Kalo08/Buddy/README.md

BuddyLogo
