Kalo08/Buddy/hardware/buddy_main/notebook/bom.csv

Refs | Value | Footprint | Qty
C1 | 100uF 16V | Capacitor_SMD:CP_Elec_6.3x7.7 | 1
C2,C4,C9,C22,C26 | 10uF 25V | Capacitor_SMD:C_1206_3216Metric | 5
C3,C5,C6,C10,C11,C19,C20,C23,C27,C32,C33,C36 | 100nF | Capacitor_SMD:C_0603_1608Metric | 12
C7,C8,C12,C13,C18 | 22uF 10V | Capacitor_SMD:C_0805_2012Metric | 5
C14-C17,C21,C34,C35,C37 | 1uF | Capacitor_SMD:C_0603_1608Metric | 8
C24,C28 | 10nF 16V | Capacitor_SMD:C_0603_1608Metric | 2
C25,C29 | 2.2uF | Capacitor_SMD:C_0603_1608Metric | 2
C30 | 47uF 16V | Capacitor_SMD:CP_Elec_6.3x7.7 | 1
C31 | 10uF 10V | Capacitor_SMD:C_0805_2012Metric | 1
D1 | SMBJ24CA | Diode_SMD:D_SMB | 1
D2 | SMAJ5.0A | Diode_SMD:D_SMA | 1
D3 | SS34 | Diode_SMD:D_SMA | 1
D4 | PWR green | LED_SMD:LED_0603_1608Metric | 1
D5 | STATUS blue | LED_SMD:LED_0603_1608Metric | 1
F1 | PTC 3A hold | Fuse:Fuse_2920_7451Metric | 1
F2 | PTC 1.1A hold | Fuse:Fuse_1206_3216Metric | 1
J1 | XT30 BATTERY | Connector_AMASS:AMASS_XT30U-M_1x02_P5.0mm_Vertical | 1
J2 | JST-PH BATTERY | Connector_JST:JST_PH_B2B-PH-K_1x02_P2.00mm_Vertical | 1
J3 | USB-C | Connector_USB:USB_C_Receptacle_GCT_USB4105-xx-A_16P_TopMnt_Horizontal | 1
J4 | UART DEBUG | Connector_PinHeader_2.54mm:PinHeader_1x04_P2.54mm_Vertical | 1
J5 | MOTOR 1 | Connector_JST:JST_XH_B2B-XH-A_1x02_P2.50mm_Vertical | 1
J6 | MOTOR 2 | Connector_JST:JST_XH_B2B-XH-A_1x02_P2.50mm_Vertical | 1
J7 | MOTOR 3 | Connector_JST:JST_XH_B2B-XH-A_1x02_P2.50mm_Vertical | 1
J8 | SPEAKER 4-8R | Connector_JST:JST_PH_B2B-PH-K_1x02_P2.00mm_Vertical | 1
J9 | I2S MIC (INMP441) | Connector_PinSocket_2.54mm:PinSocket_1x06_P2.54mm_Vertical | 1
J10 | CAMERA OV2640 24P | Connector_FFC-FPC:Hirose_FH12-24S-0.5SH_1x24-1MP_P0.50mm_Horizontal | 1
L1 | 4.7uH | Inductor_SMD:L_Bourns_SRN6045TA | 1
L2 | 6.8uH | Inductor_SMD:L_Bourns_SRN6045TA | 1
Q1 | Si4214DDY | Package_SO:SOIC-8_3.9x4.9mm_P1.27mm | 1
R1,R18 | 1M | Resistor_SMD:R_0603_1608Metric | 2
R2,R6 | 33k | Resistor_SMD:R_0603_1608Metric | 2
R3 | 56k | Resistor_SMD:R_0603_1608Metric | 1
R4,R5,R13 | 100k | Resistor_SMD:R_0603_1608Metric | 3
R7,R12 | 1k | Resistor_SMD:R_0603_1608Metric | 2
R8,R9,R14,R19,R20 | 10k | Resistor_SMD:R_0603_1608Metric | 5
R10,R11 | 5.1k | Resistor_SMD:R_0603_1608Metric | 2
R15-R17 | 0.1R 1206 | Resistor_SMD:R_1206_3216Metric | 3
R21,R22 | 4.7k | Resistor_SMD:R_0603_1608Metric | 2
SW1 | POWER | Button_Switch_SMD:SW_SPDT_PCM12 | 1
SW2 | RESET | Button_Switch_SMD:SW_SPST_PTS810 | 1
SW3 | BOOT | Button_Switch_SMD:SW_SPST_PTS810 | 1
U1 | LTC4365TS8 | Package_TO_SOT_SMD:TSOT-23-8 | 1
U2 | AP63203WU | Package_TO_SOT_SMD:TSOT-23-6 | 1
U3 | AP63205WU | Package_TO_SOT_SMD:TSOT-23-6 | 1
U4 | XC6206P282MR | Package_TO_SOT_SMD:SOT-23-3 | 1
U5 | XC6206P122MR | Package_TO_SOT_SMD:SOT-23-3 | 1
U6 | ESP32-S3-WROOM-1-N16R8 | RF_Module:ESP32-S3-WROOM-1 | 1
U7 | USBLC6-2SC6 | Package_TO_SOT_SMD:SOT-23-6 | 1
U8,U9 | DRV8833PWP | Package_SO:HTSSOP-16-1EP_4.4x5mm_P0.65mm_EP3.4x5mm_Mask2.46x2.31mm_ThermalVias | 2
U10 | MAX98357A | Package_DFN_QFN:TQFN-16-1EP_3x3mm_P0.5mm_EP1.23x1.23mm | 1
