Kalo08/Buddy/hardware/buddy_main/3d/Fuse_2920_7451Metric.step

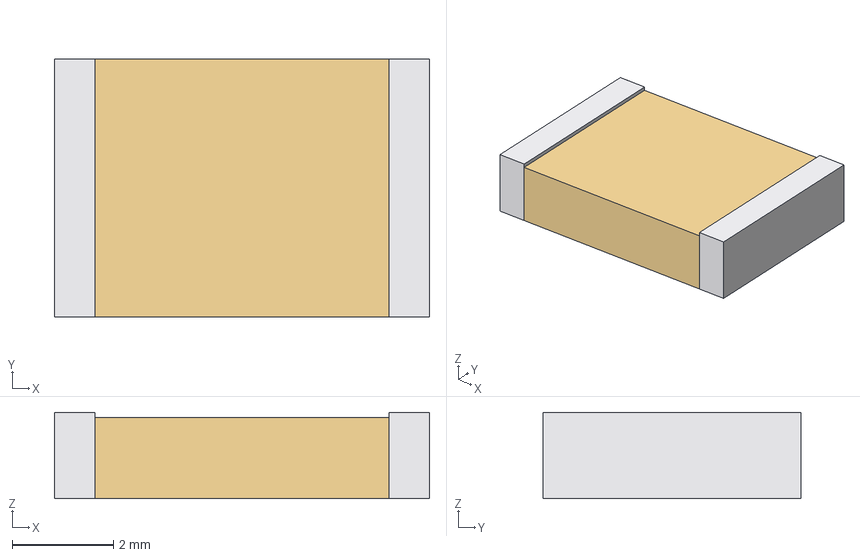
[picture p10: CAD file, 2026-10-29]
hardware/buddy_main/3d/Fuse_2920_7451Metric.step
7.40 x 5.10 x 1.70 mm
