Kalo08/Buddy/hardware/buddy_main/3d/AMASS_XT30U-M_1x02_P5.0mm_Vertical.step

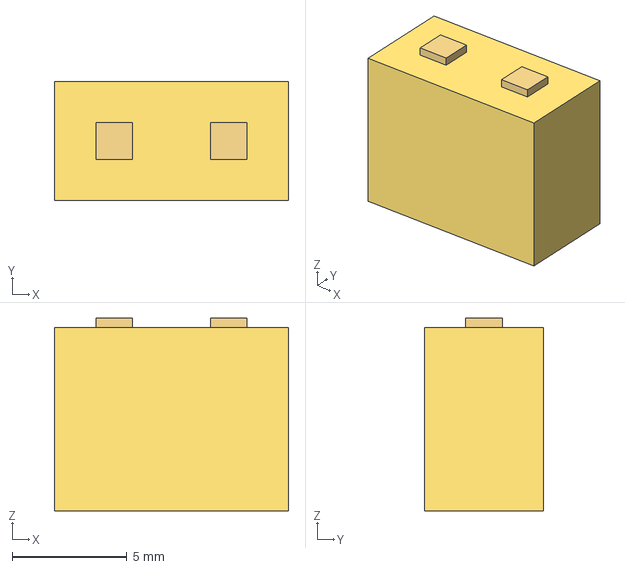
[picture p11: CAD file, 2026-10-29]
hardware/buddy_main/3d/AMASS_XT30U-M_1x02_P5.0mm_Vertical.step
10.2 x 5.20 x 8.40 mm
