Kalo08/Buddy/(list of files, drawings)

Other design files:
hardware/buddy_main/route/buddy_main.dsn
