Kalo08/Buddy/hardware/buddy_main/buddy_main.kicad_pcb

## KiCad design hardware/buddy_main/buddy_main.kicad_pcb (2026-10-31)

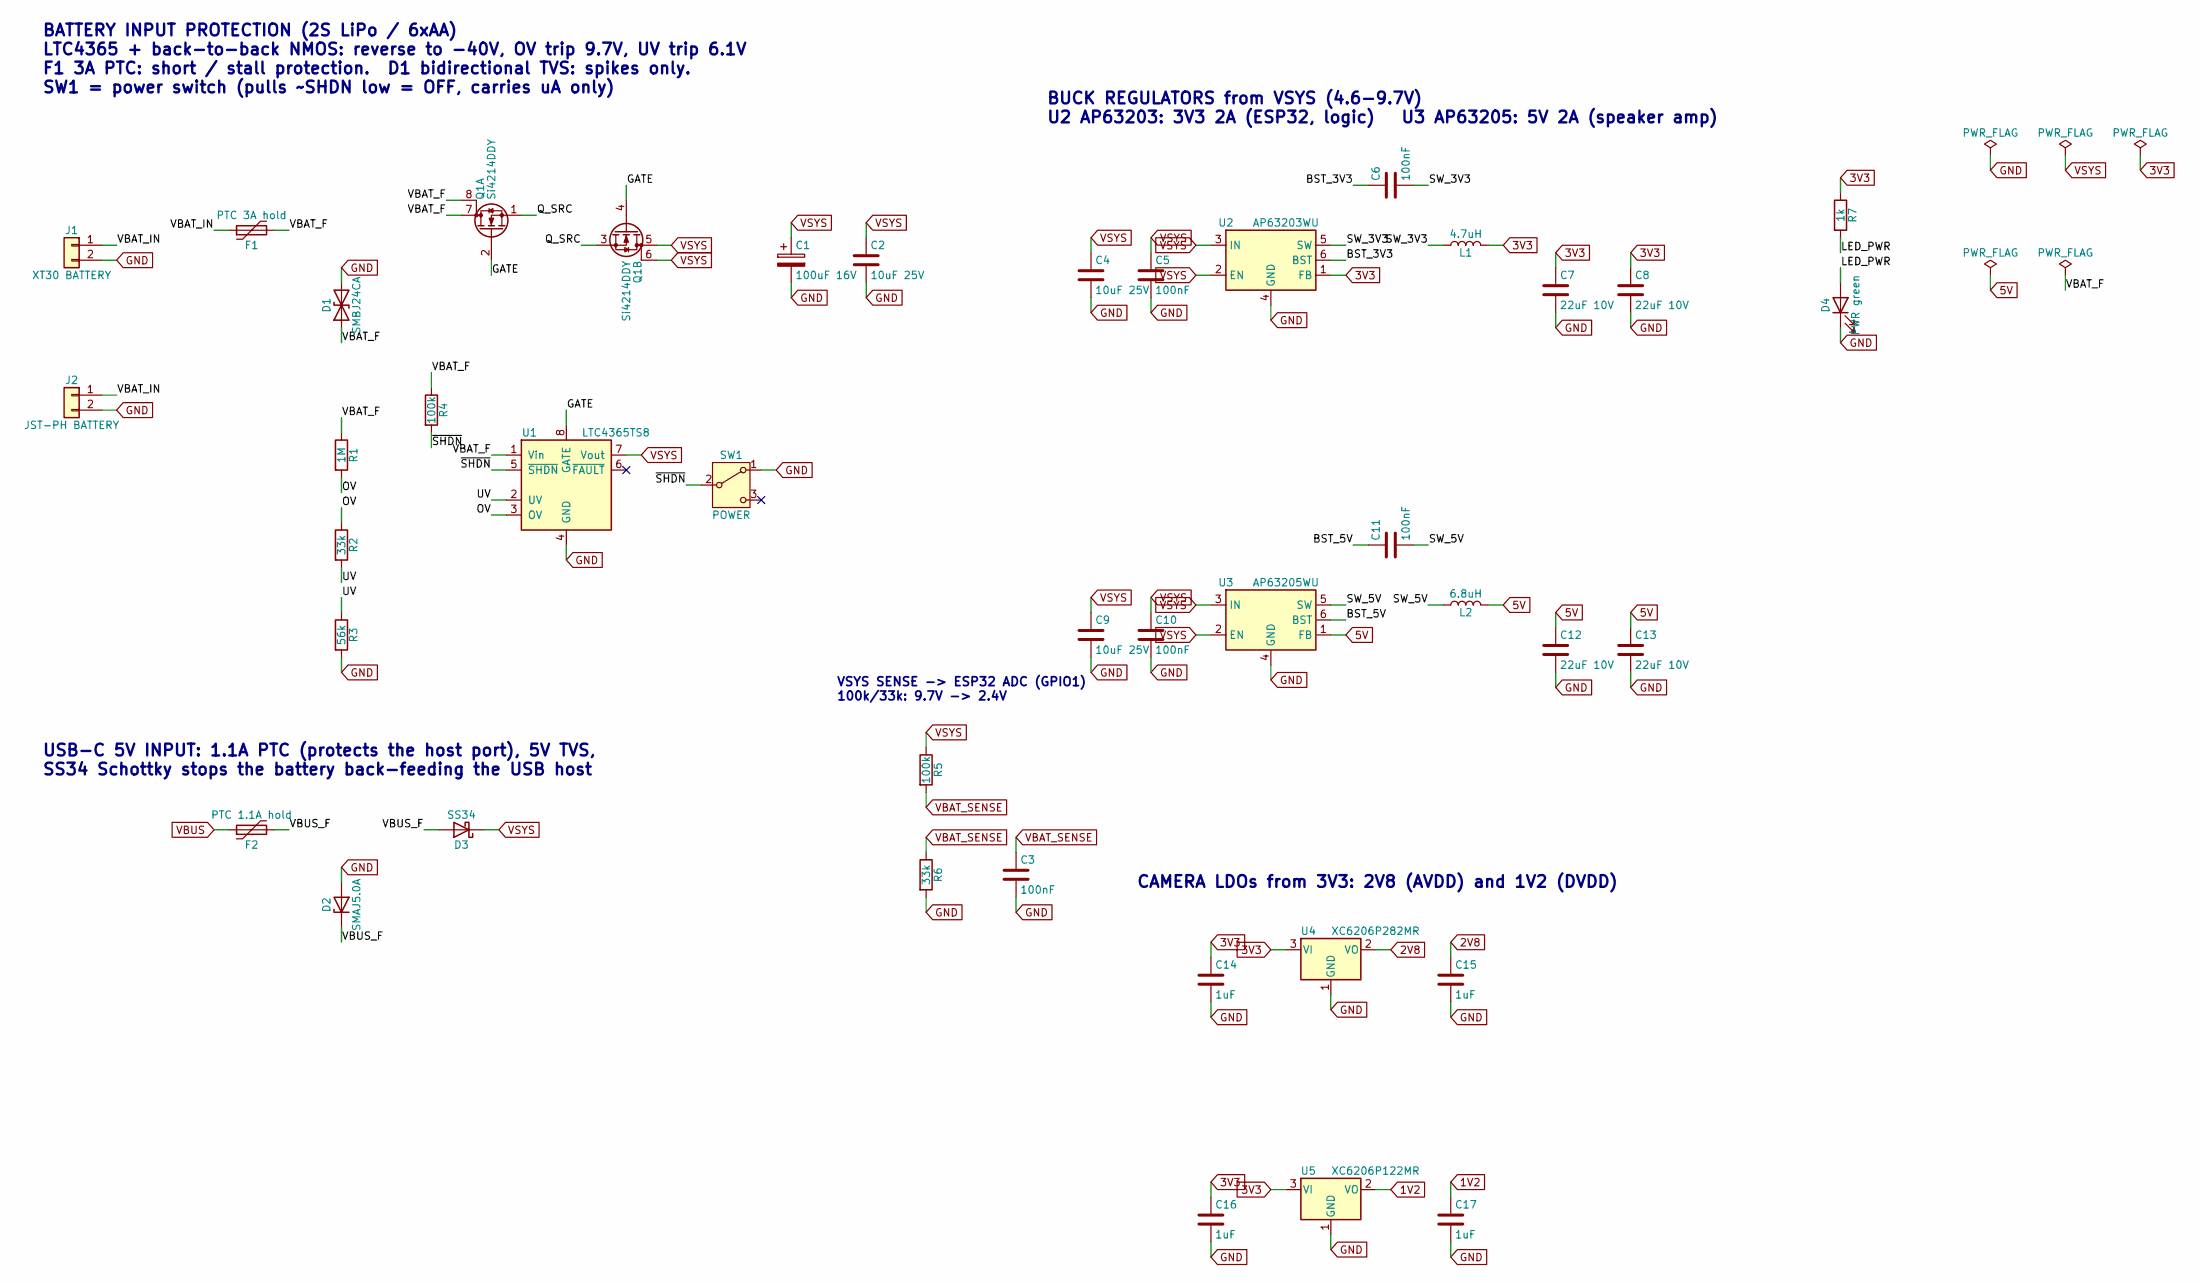
[picture p12: schematic power.kicad_sch]

Parts:
C1: 100uF 16V; CP_Elec_6.3x7.7
C2, C4, C9: 10uF 25V; C_1206_3216Metric
C3, C5, C6, C10, C11: 100nF; C_0603_1608Metric
C7, C8, C12, C13: 22uF 10V; C_0805_2012Metric
C14, C15, C16, C17: 1uF; C_0603_1608Metric
D1: SMBJ24CA; D_SMB
D2: SMAJ5.0A; D_SMA
D3: SS34; D_SMA
D4: PWR green; LED_0603_1608Metric
F1: PTC 3A hold; Fuse_2920_7451Metric
F2: PTC 1.1A hold; Fuse_1206_3216Metric
J1: XT30 BATTERY; AMASS_XT30U-M_1x02_P5.0mm_Vertical
J2: JST-PH BATTERY; JST_PH_B2B-PH-K_1x02_P2.00mm_Vertical
L1: 4.7uH; L_Bourns_SRN6045TA
L2: 6.8uH; L_Bourns_SRN6045TA
Q1: Si4214DDY; SOIC-8_3.9x4.9mm_P1.27mm
R1: 1M; R_0603_1608Metric
R2, R6: 33k; R_0603_1608Metric
R3: 56k; R_0603_1608Metric
R4, R5: 100k; R_0603_1608Metric
R7: 1k; R_0603_1608Metric
SW1: POWER; SW_SPDT_PCM12
U1: LTC4365TS8; TSOT-23-8
U2: AP63203WU; TSOT-23-6
U3: AP63205WU; TSOT-23-6
U4: XC6206P282MR; SOT-23-3
U5: XC6206P122MR; SOT-23-3

Connections:
1V2: C17.1, U5.2 (VO); also elsewhere on the board
2V8: C15.1, U4.2 (VO); also elsewhere on the board
3V3: C7.1, C8.1, C14.1, C16.1, L1.2, R7.1, U2.1 (FB), U4.3 (VI), U5.3 (VI); also elsewhere on the board
5V: C12.1, C13.1, L2.2, U3.1 (FB); also elsewhere on the board
/Power and Protection/BST_3V3: C6.1, U2.6 (BST)
/Power and Protection/BST_5V: C11.1, U3.6 (BST)
/Power and Protection/GATE: Q1.2 (G), Q1.4 (G), U1.8 (GATE)
/Power and Protection/LED_PWR: D4.2 (A), R7.2
/Power and Protection/OV: R1.2, R2.1, U1.3 (OV)
/Power and Protection/Q_SRC: Q1.1 (S), Q1.3 (S)
/Power and Protection/SW_3V3: C6.2, L1.1, U2.5 (SW)
/Power and Protection/SW_5V: C11.2, L2.1, U3.5 (SW)
/Power and Protection/UV: R2.2, R3.1, U1.2 (UV)
/Power and Protection/VBAT_F: D1.1 (A1), F1.2, Q1.7 (D), Q1.8 (D), R1.1, R4.1, U1.1 (Vin)
/Power and Protection/VBAT_IN: F1.1, J1.1, J2.1
/Power and Protection/VBUS_F: D2.1 (K), D3.2 (A), F2.2
/Power and Protection/~SHDN: R4.2, SW1.2 (B), U1.5 (~SHDN)
GND: C1.2, C2.2, C3.2, C4.2, C5.2, C7.2, C8.2, C9.2, C10.2, C12.2, C13.2, C14.2, C15.2, C16.2, C17.2, D1.2 (A2), D2.2 (A), D4.1 (K), J1.2, J2.2, R3.2, R6.2, SW1.1 (A), U1.4 (GND), U2.4 (GND), U3.4 (GND), U4.1 (GND), U5.1 (GND); also elsewhere on the board
VBAT_SENSE: C3.1, R5.2, R6.1; also elsewhere on the board
VBUS: F2.1; also elsewhere on the board
VSYS: C1.1, C2.1, C4.1, C5.1, C9.1, C10.1, D3.1 (K), Q1.5 (D), Q1.6 (D), R5.1, U1.7 (Vout), U2.2 (EN), U2.3 (IN), U3.2 (EN), U3.3 (IN); also elsewhere on the board

Notes on the sheet:
BATTERY INPUT PROTECTION (2S LiPo / 6xAA) LTC4365 + back-to-back NMOS: reverse to -40V, OV trip 9.7V, UV trip 6.1V F1 3A PTC: short / stall protection. D1 bidirectional TVS: spikes only. SW1 = power switch (pulls ~SHDN low = OFF, carries uA only)
USB-C 5V INPUT: 1.1A PTC (protects the host port), 5V TVS, SS34 Schottky stops the battery back-feeding the USB host
BUCK REGULATORS from VSYS (4.6-9.7V) U2 AP63203: 3V3 2A (ESP32, logic) U3 AP63205: 5V 2A (speaker amp)
CAMERA LDOs from 3V3: 2V8 (AVDD) and 1V2 (DVDD)
VSYS SENSE -> ESP32 ADC (GPIO1) 100k/33k: 9.7V -> 2.4V

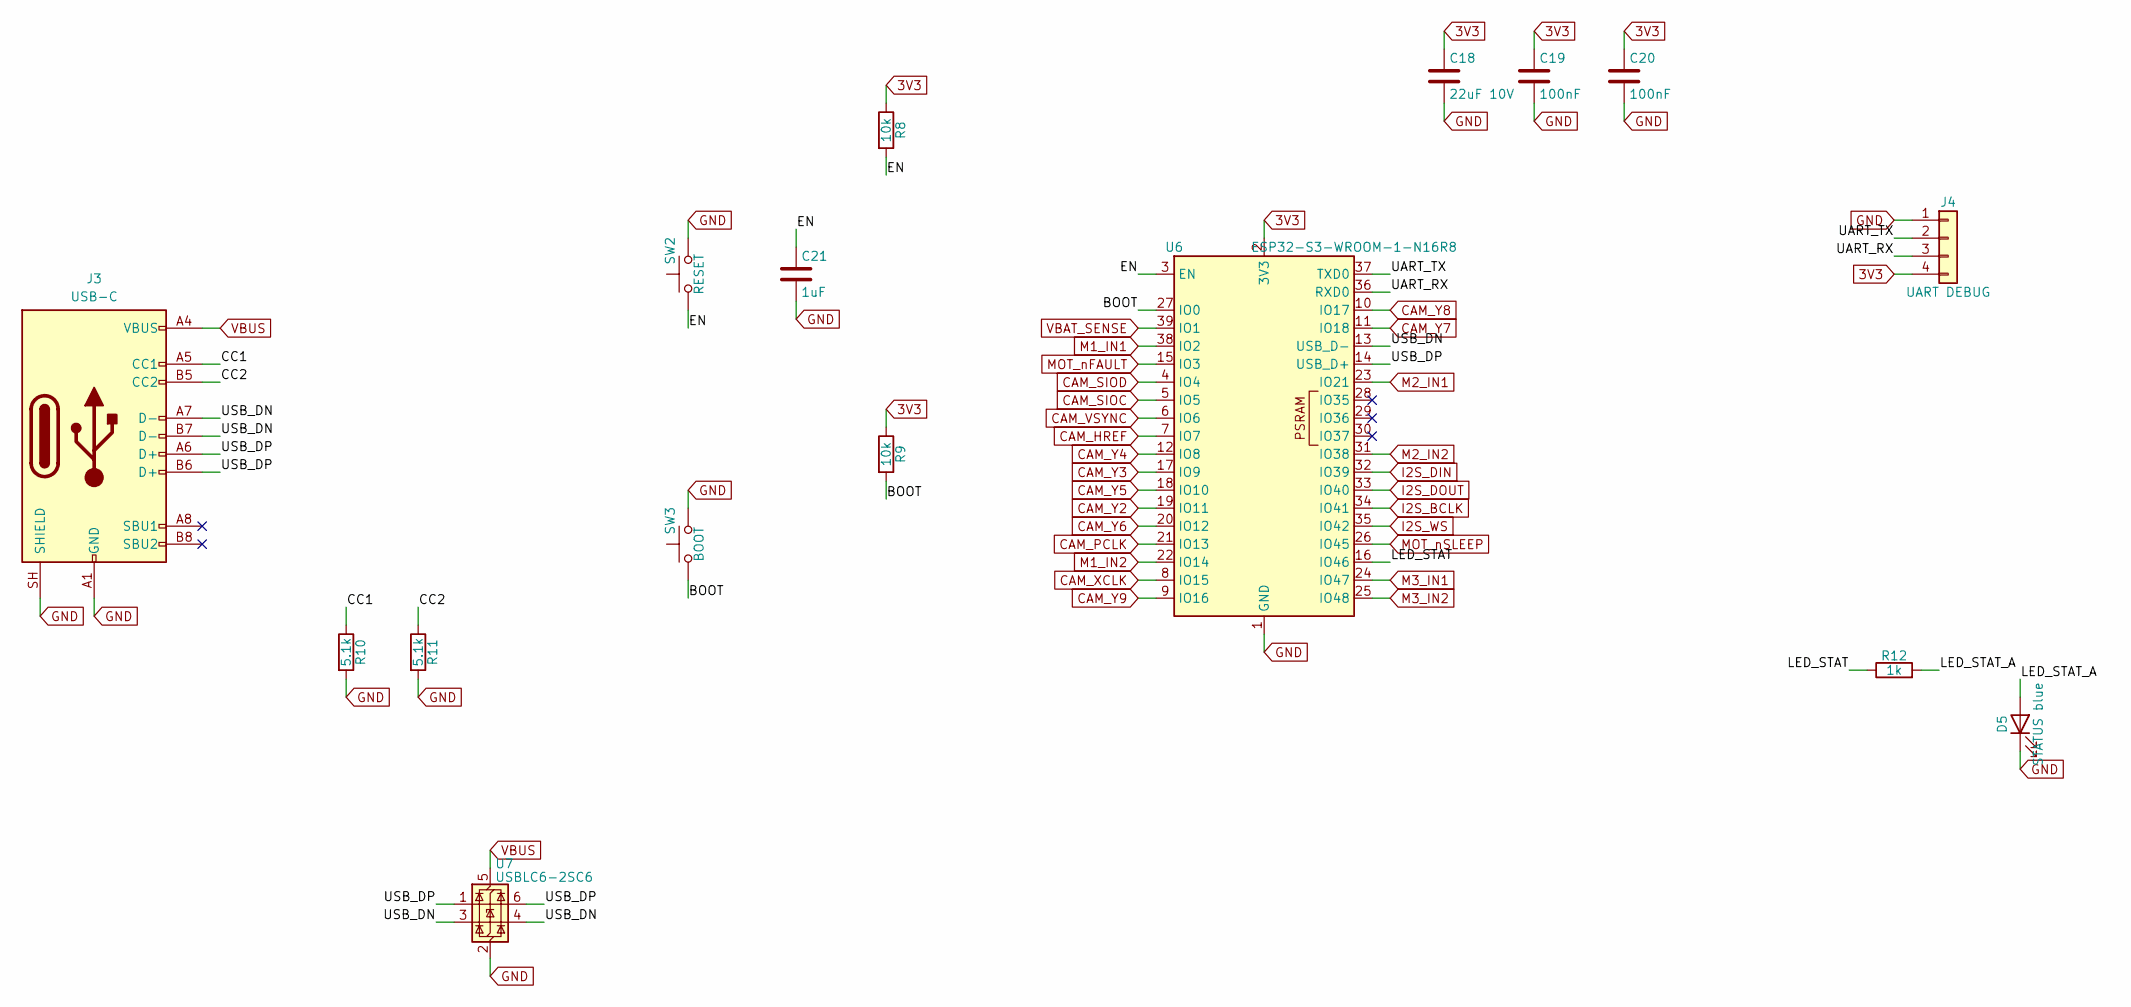
[picture p13: schematic mcu.kicad_sch]

Parts:
C18: 22uF 10V; C_0805_2012Metric
C19, C20: 100nF; C_0603_1608Metric
C21: 1uF; C_0603_1608Metric
D5: STATUS blue; LED_0603_1608Metric
J3: USB-C; USB_C_Receptacle_GCT_USB4105-xx-A_16P_TopMnt_Horizontal
J4: UART DEBUG; PinHeader_1x04_P2.54mm_Vertical
R8, R9: 10k; R_0603_1608Metric
R10, R11: 5.1k; R_0603_1608Metric
R12: 1k; R_0603_1608Metric
SW2: RESET; SW_SPST_PTS810
SW3: BOOT; SW_SPST_PTS810
U6: ESP32-S3-WROOM-1-N16R8; ESP32-S3-WROOM-1
U7: USBLC6-2SC6; SOT-23-6

Connections:
3V3: C18.1, C19.1, C20.1, J4.4, R8.1, R9.1, U6.2 (3V3); also elsewhere on the board
/MCU and USB/BOOT: R9.2, SW3.1, U6.27 (IO0)
/MCU and USB/CC1: J3.A5 (CC1), R10.1
/MCU and USB/CC2: J3.B5 (CC2), R11.1
/MCU and USB/EN: C21.1, R8.2, SW2.1, U6.3 (EN)
/MCU and USB/LED_STAT: R12.1, U6.16 (IO46)
/MCU and USB/LED_STAT_A: D5.2 (A), R12.2
/MCU and USB/UART_RX: J4.3, U6.36 (RXD0)
/MCU and USB/UART_TX: J4.2, U6.37 (TXD0)
/MCU and USB/USB_DN: J3.A7 (D-), J3.B7 (D-), U6.13 (USB_D-), U7.3 (I/O2), U7.4 (I/O2)
/MCU and USB/USB_DP: J3.A6 (D+), J3.B6 (D+), U6.14 (USB_D+), U7.1 (I/O1), U7.6 (I/O1)
CAM_HREF: U6.7 (IO7); also elsewhere on the board
CAM_PCLK: U6.21 (IO13); also elsewhere on the board
CAM_SIOC: U6.5 (IO5); also elsewhere on the board
CAM_SIOD: U6.4 (IO4); also elsewhere on the board
CAM_VSYNC: U6.6 (IO6); also elsewhere on the board
CAM_XCLK: U6.8 (IO15); also elsewhere on the board
CAM_Y2: U6.19 (IO11); also elsewhere on the board
CAM_Y3: U6.17 (IO9); also elsewhere on the board
CAM_Y4: U6.12 (IO8); also elsewhere on the board
CAM_Y5: U6.18 (IO10); also elsewhere on the board
CAM_Y6: U6.20 (IO12); also elsewhere on the board
CAM_Y7: U6.11 (IO18); also elsewhere on the board
CAM_Y8: U6.10 (IO17); also elsewhere on the board
CAM_Y9: U6.9 (IO16); also elsewhere on the board
GND: C18.2, C19.2, C20.2, C21.2, D5.1 (K), J3.A1 (GND), J3.A12 (GND), J3.B1 (GND), J3.B12 (GND), J3.SH (SHIELD), J4.1, R10.2, R11.2, SW2.2, SW3.2, U6.1 (GND), U6.40 (GND), U6.41 (GND), U7.2 (GND); also elsewhere on the board
I2S_BCLK: U6.34 (IO41); also elsewhere on the board
I2S_DIN: U6.32 (IO39); also elsewhere on the board
I2S_DOUT: U6.33 (IO40); also elsewhere on the board
I2S_WS: U6.35 (IO42); also elsewhere on the board
M1_IN1: U6.38 (IO2); also elsewhere on the board
M1_IN2: U6.22 (IO14); also elsewhere on the board
M2_IN1: U6.23 (IO21); also elsewhere on the board
M2_IN2: U6.31 (IO38); also elsewhere on the board
M3_IN1: U6.24 (IO47); also elsewhere on the board
M3_IN2: U6.25 (IO48); also elsewhere on the board
MOT_nFAULT: U6.15 (IO3); also elsewhere on the board
MOT_nSLEEP: U6.26 (IO45); also elsewhere on the board
VBAT_SENSE: U6.39 (IO1); also elsewhere on the board
VBUS: J3.A4 (VBUS), J3.A9 (VBUS), J3.B4 (VBUS), J3.B9 (VBUS), U7.5 (VBUS); also elsewhere on the board

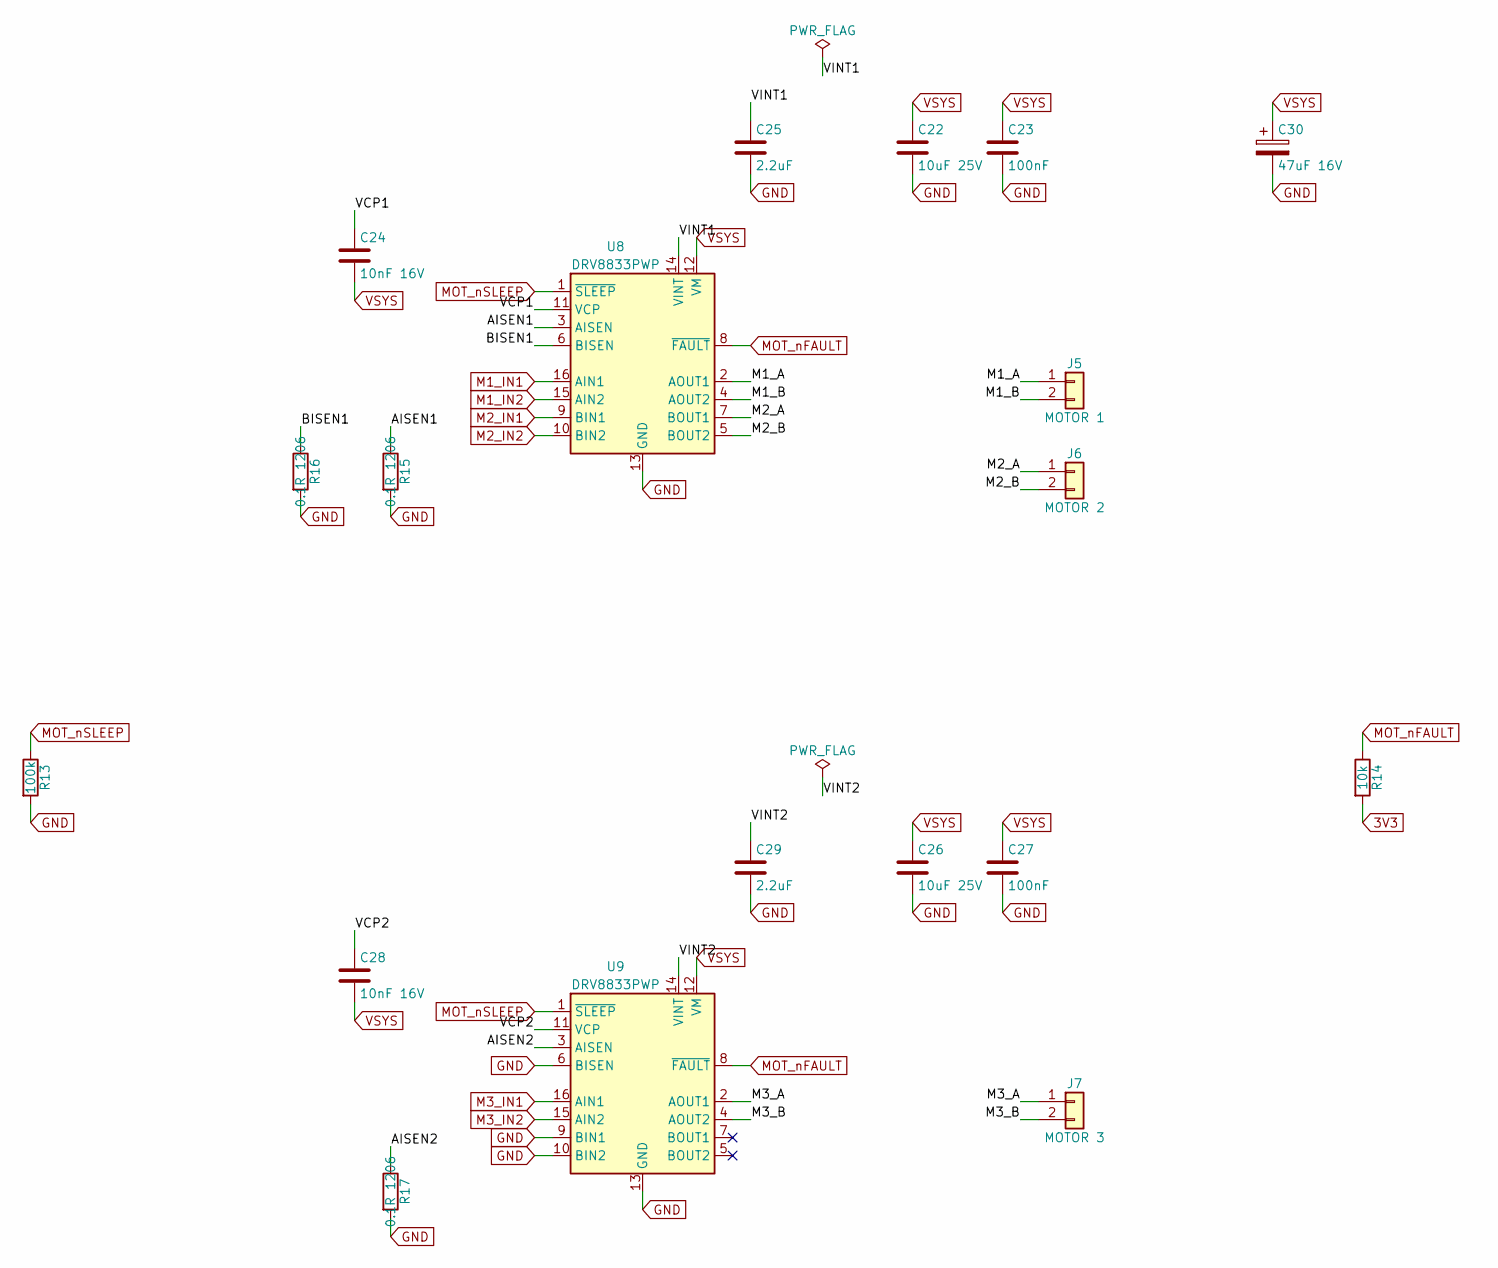
[picture p14: schematic motors.kicad_sch]

Parts:
C22, C26: 10uF 25V; C_1206_3216Metric
C23, C27: 100nF; C_0603_1608Metric
C24, C28: 10nF 16V; C_0603_1608Metric
C25, C29: 2.2uF; C_0603_1608Metric
C30: 47uF 16V; CP_Elec_6.3x7.7
J5: MOTOR 1; JST_XH_B2B-XH-A_1x02_P2.50mm_Vertical
J6: MOTOR 2; JST_XH_B2B-XH-A_1x02_P2.50mm_Vertical
J7: MOTOR 3; JST_XH_B2B-XH-A_1x02_P2.50mm_Vertical
R13: 100k; R_0603_1608Metric
R14: 10k; R_0603_1608Metric
R15, R16, R17: 0.1R 1206; R_1206_3216Metric
U8, U9: DRV8833PWP; HTSSOP-16-1EP_4.4x5mm_P0.65mm_EP3.4x5mm_Mask2.46x2.31mm_The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

Connections:
3V3: R14.2; also elsewhere on the board
/Motor Drivers/AISEN1: R15.1, U8.3 (AISEN)
/Motor Drivers/AISEN2: R17.1, U9.3 (AISEN)
/Motor Drivers/BISEN1: R16.1, U8.6 (BISEN)
/Motor Drivers/M1_A: J5.1, U8.2 (AOUT1)
/Motor Drivers/M1_B: J5.2, U8.4 (AOUT2)
/Motor Drivers/M2_A: J6.1, U8.7 (BOUT1)
/Motor Drivers/M2_B: J6.2, U8.5 (BOUT2)
/Motor Drivers/M3_A: J7.1, U9.2 (AOUT1)
/Motor Drivers/M3_B: J7.2, U9.4 (AOUT2)
/Motor Drivers/VCP1: C24.1, U8.11 (VCP)
/Motor Drivers/VCP2: C28.1, U9.11 (VCP)
/Motor Drivers/VINT1: C25.1, U8.14 (VINT)
/Motor Drivers/VINT2: C29.1, U9.14 (VINT)
GND: C22.2, C23.2, C25.2, C26.2, C27.2, C29.2, C30.2, R13.2, R15.2, R16.2, R17.2, U8.13 (GND), U8.17 (GND), U9.6 (BISEN), U9.9 (BIN1), U9.10 (BIN2), U9.13 (GND), U9.17 (GND); also elsewhere on the board
M1_IN1: U8.16 (AIN1); also elsewhere on the board
M1_IN2: U8.15 (AIN2); also elsewhere on the board
M2_IN1: U8.9 (BIN1); also elsewhere on the board
M2_IN2: U8.10 (BIN2); also elsewhere on the board
M3_IN1: U9.16 (AIN1); also elsewhere on the board
M3_IN2: U9.15 (AIN2); also elsewhere on the board
MOT_nFAULT: R14.1, U8.8 (~FAULT), U9.8 (~FAULT); also elsewhere on the board
MOT_nSLEEP: R13.1, U8.1 (~SLEEP), U9.1 (~SLEEP); also elsewhere on the board
VSYS: C22.1, C23.1, C24.2, C26.1, C27.1, C28.2, C30.1, U8.12 (VM), U9.12 (VM); also elsewhere on the board

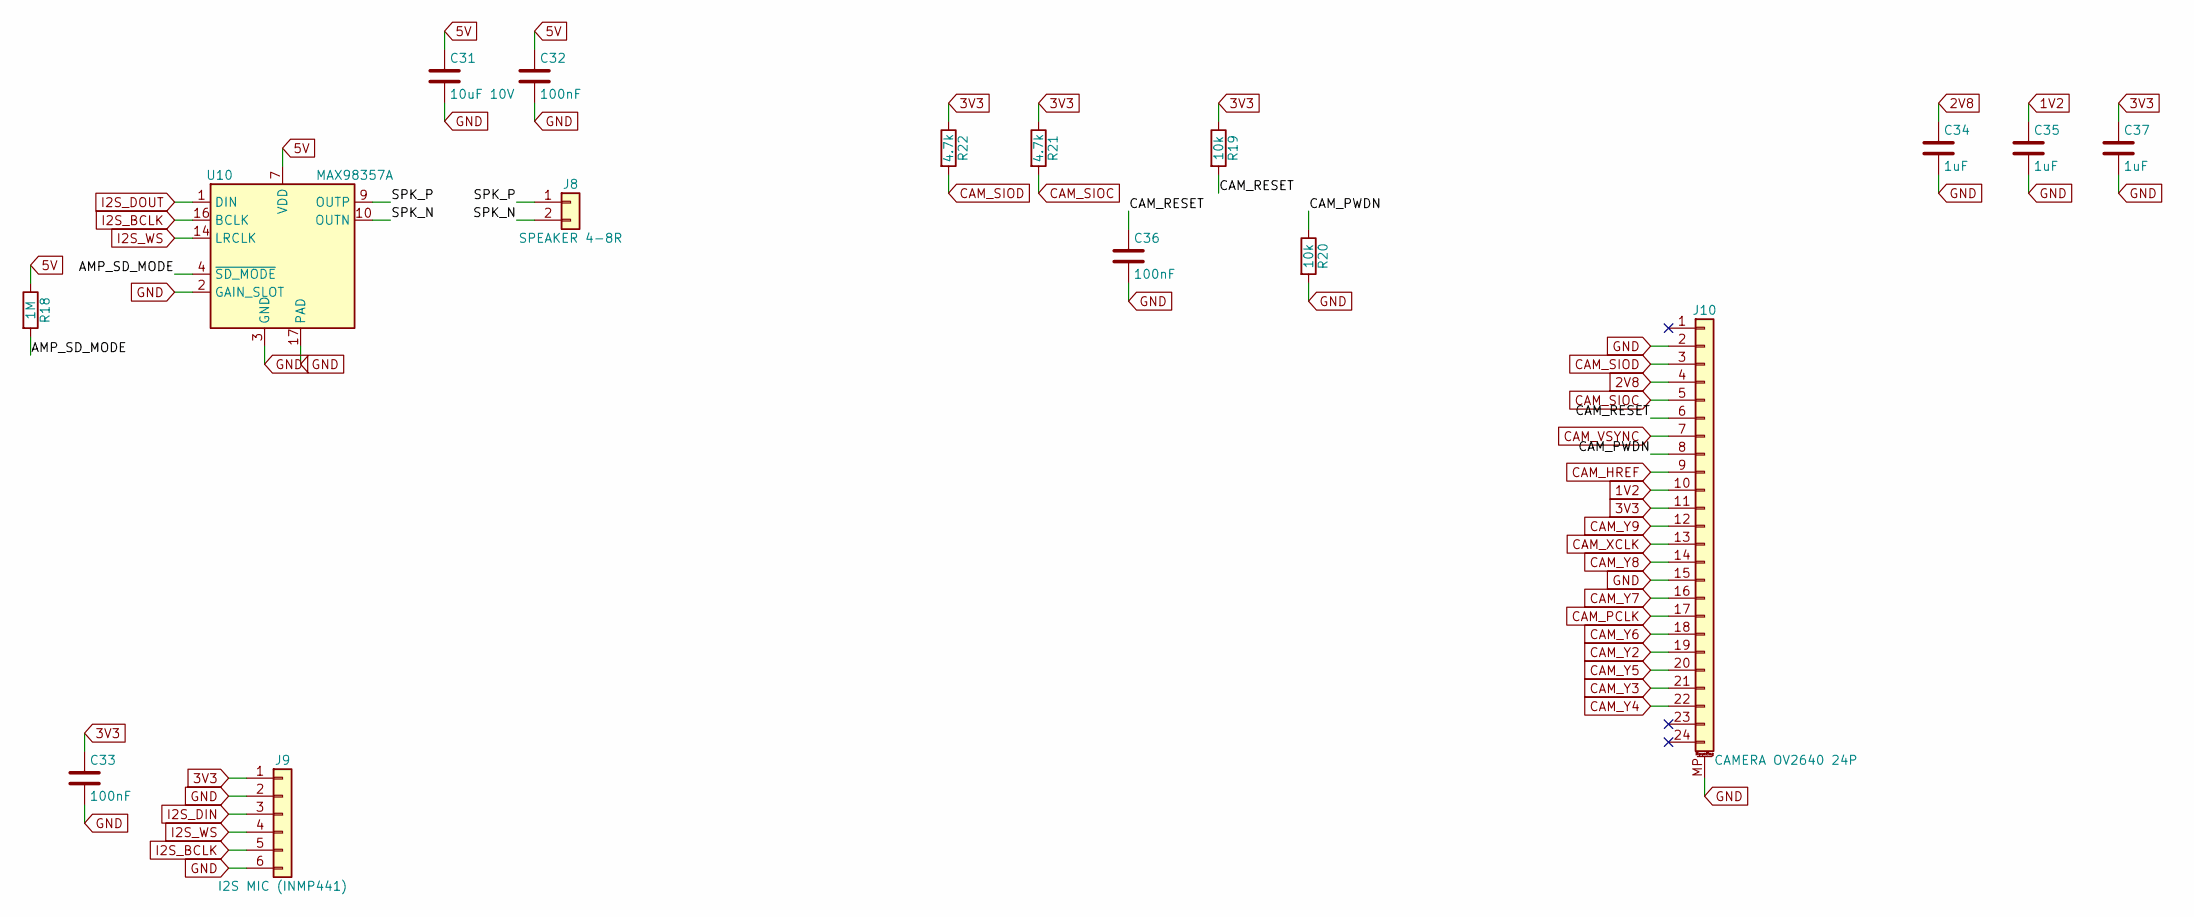
[picture p15: schematic audio_camera.kicad_sch]

Parts:
C31: 10uF 10V; C_0805_2012Metric
C32, C33, C36: 100nF; C_0603_1608Metric
C34, C35, C37: 1uF; C_0603_1608Metric
J8: SPEAKER 4-8R; JST_PH_B2B-PH-K_1x02_P2.00mm_Vertical
J9: I2S MIC (INMP441); PinSocket_1x06_P2.54mm_Vertical
J10: CAMERA OV2640 24P; Hirose_FH12-24S-0.5SH_1x24-1MP_P0.50mm_Horizontal
R18: 1M; R_0603_1608Metric
R19, R20: 10k; R_0603_1608Metric
R21, R22: 4.7k; R_0603_1608Metric
U10: MAX98357A; TQFN-16-1EP_3x3mm_P0.5mm_EP1.23x1.23mm

Connections:
1V2: C35.1, J10.10; also elsewhere on the board
2V8: C34.1, J10.4; also elsewhere on the board
3V3: C33.1, C37.1, J9.1, J10.11, R19.1, R21.1, R22.1; also elsewhere on the board
5V: C31.1, C32.1, R18.1, U10.7 (VDD), U10.8 (VDD); also elsewhere on the board
/Audio and Camera/AMP_SD_MODE: R18.2, U10.4 (~SD_MODE)
/Audio and Camera/CAM_PWDN: J10.8, R20.1
/Audio and Camera/CAM_RESET: C36.1, J10.6, R19.2
/Audio and Camera/SPK_N: J8.2, U10.10 (OUTN)
/Audio and Camera/SPK_P: J8.1, U10.9 (OUTP)
CAM_HREF: J10.9; also elsewhere on the board
CAM_PCLK: J10.17; also elsewhere on the board
CAM_SIOC: J10.5, R21.2; also elsewhere on the board
CAM_SIOD: J10.3, R22.2; also elsewhere on the board
CAM_VSYNC: J10.7; also elsewhere on the board
CAM_XCLK: J10.13; also elsewhere on the board
CAM_Y2: J10.19; also elsewhere on the board
CAM_Y3: J10.21; also elsewhere on the board
CAM_Y4: J10.22; also elsewhere on the board
CAM_Y5: J10.20; also elsewhere on the board
CAM_Y6: J10.18; also elsewhere on the board
CAM_Y7: J10.16; also elsewhere on the board
CAM_Y8: J10.14; also elsewhere on the board
CAM_Y9: J10.12; also elsewhere on the board
GND: C31.2, C32.2, C33.2, C34.2, C35.2, C36.2, C37.2, J9.2, J9.6, J10.2, J10.15, J10.MP (MountPin), R20.2, U10.2 (GAIN_SLOT), U10.3 (GND), U10.11 (GND), U10.15 (GND), U10.17 (PAD); also elsewhere on the board
I2S_BCLK: J9.5, U10.16 (BCLK); also elsewhere on the board
I2S_DIN: J9.3; also elsewhere on the board
I2S_DOUT: U10.1 (DIN); also elsewhere on the board
I2S_WS: J9.4, U10.14 (LRCLK); also elsewhere on the board

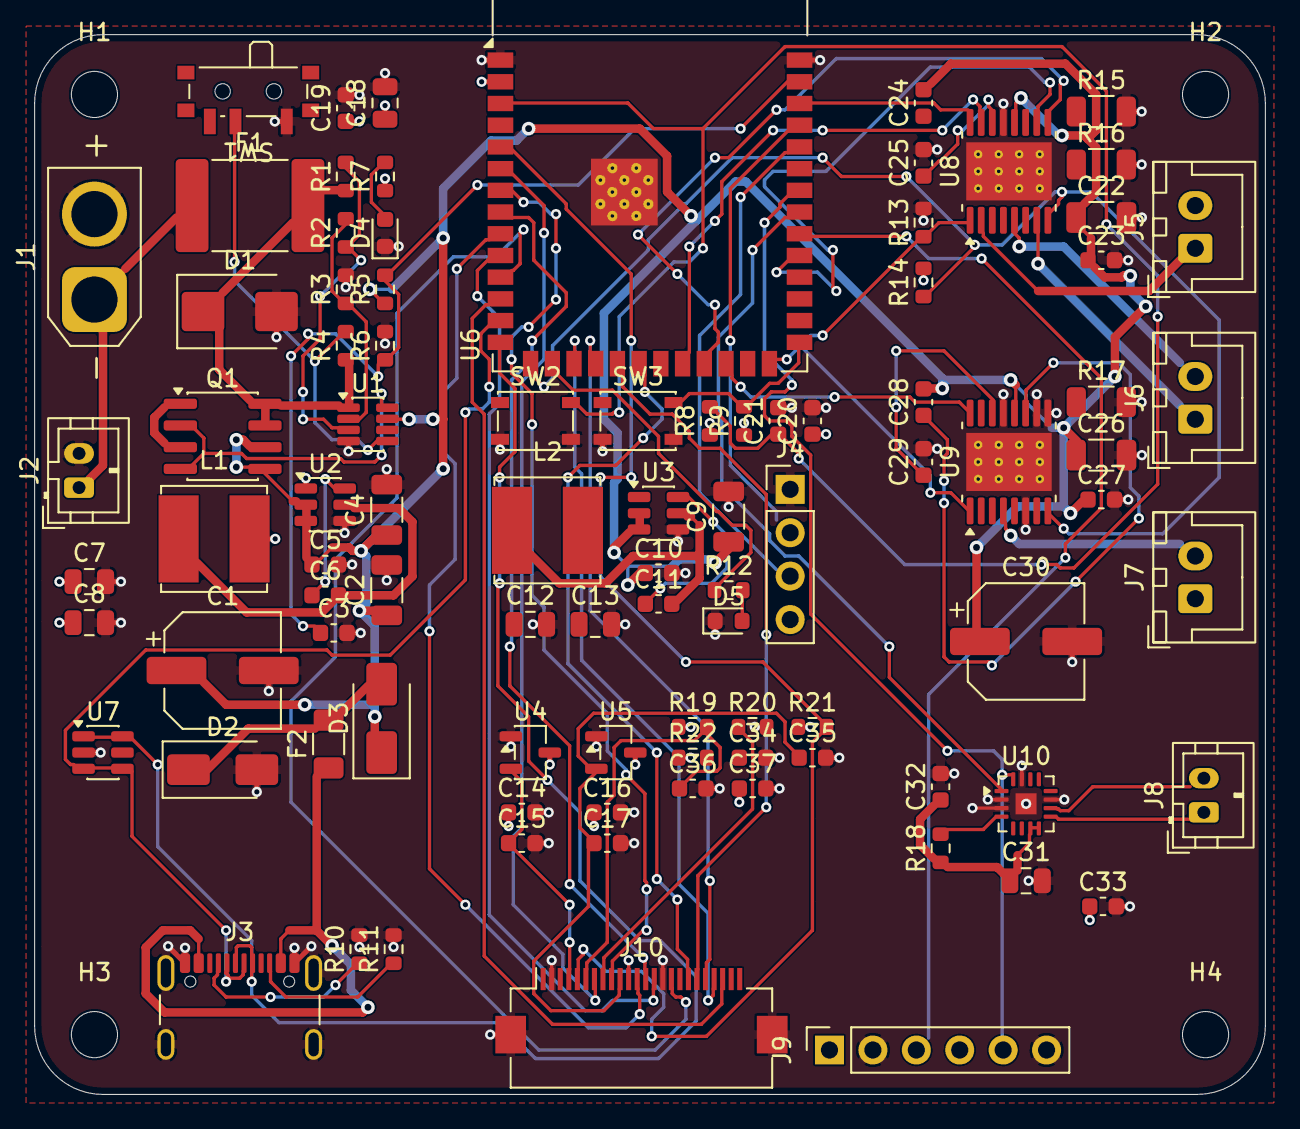
[picture p16: board buddy_main.kicad_pcb from above]

Board: 4 copper layers, 72.0 x 62.0 mm, 96 parts (0 on the bottom side), 75 nets.

Other parts of the board:
H1, H2, H3, H4: MountingHole_2.7mm
