Kalo08/Buddy/(commit log)

2026-07-11 Port device from fried ESP32-CAM to Raspberry Pi 3 + USB camera
    - pi/buddy_pi.py: Python device client speaking the same WS protocol
    (0x01+JPEG video out, 0x02 audio in, JSON cmd/servo) — USB camera via
    OpenCV, PCA9685 servos over Pi I2C with the same drive math/calibration,
    hold-to-talk audio now actually plays via ffplay
    - pi/README.md: wiring, setup, calibration, systemd unit
    - server.js: update ESP32 references in comments/logs
2026-07-11 Fix servo control for pot-decoupled continuous servos + actual wheel layout
    - Speed-based control in a narrow pulse band (1500us +/- 200us) with a
    stop deadband, replacing the 500-2500us positional sweep that was
    slamming the converted servos (the grinding noise)
    - Correct drive geometry: two wheels in front (+/-60deg), one sideways in
    back (180deg) — was one front / two back, which made wheels fight
    - Calibration trim now in us (STOP_TRIM_US); servo message = 2us/degree
    [buddy_pi.py]
2026-07-11 Fix zombie-socket race that silently deregisters a reconnected device
    A replaced socket's late close event unconditionally nulled the registry
    entry, wiping out the replacement — the device stayed connected but the
    server forgot it, so clients saw "waiting" forever. Guard the close
    handlers, and add a ping/pong heartbeat to reap dead sockets promptly.
2026-07-11 Servos: no signal at idle — pulses only while a button is held
    Pot-decoupled servos drive toward their frozen pot reading on ANY pulse,
    so a nominal stop pulse can mean full-speed grinding if the pot froze
    off-center. Idle/stop now cuts the PCA9685 channel entirely (full-off
    flag): wheels sit limp and silent until a command arrives. Calibration
    messages map 0-180 onto 500-2500us, log the pulse, and angle -1 = off.
2026-07-11 Add stall-protection burst mode for frozen-pot servos
    The servo firmware sees a position error that never shrinks (pot is
    mechanically decoupled), decides the motor is stalled, and fades power
    out after a few seconds — recoverable only by power-cycling. While
    driving, cut each active channel's signal for BURST_OFF_MS (60ms) every
    BURST_ON_MS (400ms) so the protection timer keeps resetting; wheel
    inertia smooths the gaps. BURST_OFF_MS = 0 disables.
    [buddy_pi.py]
2026-07-11 Extend stall-protection bursting to calibration commands
    Calibration sweeps were latching the servo's stall protection (servo
    goes dead until power-cycled), making neutral-finding nearly impossible.
    Calibration pulses now persist per-channel and get the same on/off burst
    treatment as drive commands; drive overrides calibration per channel.
    [buddy_pi.py]
2026-07-11 Replace burst gaps with command dithering for stall protection
    Field testing showed the servo firmware re-arms on a CHANGED command,
    not on signal gaps — off-then-same-value does nothing, but a different
    target buys another run. So instead of silence windows, alternate every
    active channel's pulse between its base value and base +/- DITHER_US
    (away from neutral, so no direction flips) every DITHER_MS.
    [buddy_pi.py]
2026-07-11 Add rest cycling: drive in bursts with seconds-long silence windows
    Field testing showed the stall protection only clears after ~1-2s of no
    signal — 60ms gaps and command dithering alone don't cut it. Drive for
    REST_ON_MS, then silence all active channels for REST_OFF_MS, repeat.
    Motion pulses but never permanently stalls. Dither still runs during
    the on-window.
    [buddy_pi.py]
2026-07-11 Halve drive strength (DRIVE_US 200 -> 100)
    Robot was already fast, and smaller pulse offsets keep the frozen-pot
    servos' drive gentler — less likely to trip stall protection.
    [buddy_pi.py]
2026-07-11 Expose servo tuning as CLI flags — no more file edits to experiment
    --drive-us, --dither-us/--dither-ms, --rest-on/--rest-off, --neutral
    override the module constants at startup and are logged on boot.
2026-07-12 Add --rest-neutral: rest at 'target reached' instead of silence
    Field testing proved the stall detector watches the pot itself (turning
    the pot by hand prevents the cutoff; a static pot trips it in ~2s even
    unloaded). Signal tricks can't fake pot movement, but commanding the
    neutral pulse reads as 'target reached' — which may reset the detector
    in a fraction of the 1-2s a silent rest needs.
    [buddy_pi.py]
2026-07-12 Default dither and rest cycling to OFF — raw behavior unless flagged
    Calibration (pot centering) needs uninterrupted pulses; the rest windows
    were cutting the motor every 2s and masking the true center. Plain runs
    are now raw; enable workarounds explicitly with --dither-ms / --rest-off
    for driving sessions.
    [buddy_pi.py]
2026-07-12 Dither/rest apply only to D-pad driving, never to calibration commands
    Browser-console servo messages now always emit one raw steady pulse so
    pot centering gets clean feedback. Removed the now-unused cal_us state.
2026-07-12 Default rest-on window to 4s (measured stall cutoff ~5s)
    [buddy_pi.py]
2026-07-12 Bake in the winning servo formula as defaults
    rest = 4s drive / 100ms neutral-visit, on by default — a plain run is
    driving-ready. --rest-silence switches the rest style back to no-signal.
    Calibration console commands stay raw regardless (unaffected by rest).
2026-07-12 Record back wheel's measured neutral: 1494us (stop angle 89.5)
2026-07-12 Audio can no longer take down the connection; support Firefox ogg streams
    The speaker wrote to ffplay's stdin on the asyncio loop — when ffplay
    choked on Firefox's ogg/opus chunks and stopped consuming, the write
    blocked, pings went unanswered, and the whole WS dropped (1011 keepalive
    timeout). All pipe I/O now runs on a worker thread behind a bounded
    drop-on-full queue, and OggS-headed streams get spawned with -f ogg so
    Firefox audio decodes without probing.
    [buddy_pi.py]
2026-07-12 Record front-left wheel's measured neutral: 1489us (stop angle 89)
2026-07-12 Record front-right wheel's measured neutral: 1494us (stop angle 89.5)
    All three wheels now calibrated: FL 1489, FR 1494, back 1494.
2026-07-12 Flip front wheels' drive direction (mounted mirrored vs the drive math)
    [buddy_pi.py]
2026-07-12 Fix ogg stream detection: OggS heads EVERY page, not just the stream
    Every browser audio chunk was treated as a fresh stream, killing and
    respawning ffplay per chunk — each new player started mid-stream with
    no codec header (Codec not found) and died at once (End of file), so
    no audio ever played. A stream truly starts only on a page with the
    BOS flag (byte 5 bit 0x02); mid-stream pages now feed the live player.
    [buddy_pi.py]
2026-07-12 Speaker: standard buffering + --dump-audio debug capture
    The zero-buffer flags (nobuffer / probesize 32 / analyzeduration 0)
    produced a player that opened ALSA, underran once, and stayed silent on
    chunked network audio. Use ffplay's normal buffering, and add
    --dump-audio PATH to save the raw browser stream for offline testing.
2026-07-12 Make speak button and d-pad unselectable (no text highlight on press)
    user-select: none + tap-highlight/touch-action for mobile long-press.
2026-07-12 Speak button: live sent-KB meter and visible failure reasons
    Holding speak now shows a running "sending audio... X KB" counter (real
    voice = KBs per second, dead mic = ~0.1 KB chunks), says so when the mic
    toggle is muted instead of silently doing nothing, and surfaces recorder
    and getUserMedia errors by name.
2026-07-12 Add disconnect button to the hub sidebar
    Cleanly releases the d-pad, stops the mic, and closes the socket —
    the Pi sees client_disconnected and cuts servo outputs as usual.
2026-07-12 Mic: default to plughw (ALSA converts rate/format) and log arecord errors
    Bare hw:1 dies instantly when the USB mic doesn't natively support
    16kHz mono S16 — plughw resamples. arecord's stderr now surfaces in
    the log instead of being discarded, so device failures say why.
    [buddy_pi.py]
2026-07-15 Add per-wheel speed gain to correct drive drift (FR boosted 1.1x)
    Robot pulled left going forward; WHEEL_GAIN scales each wheel's
    commanded speed, tunable at runtime via --gain FL,FR,B.
    [buddy_pi.py]
2026-07-16 Drive servos from GPIO pins 11/13/15 directly, dropping the PCA9685
    Signal pulses now come from RPi.GPIO software PWM (BOARD pins 11/13/15
    = GPIO17/27/22). Same no-signal-at-idle behavior, neutral calibration,
    and dither/rest stall workarounds. Also repairs pre-existing file
    corruption (DEADBAND typo, doubled try block, merged methods) that made
    the script unparseable.
    [buddy_pi.py]
2026-07-16 Boost the slow front-left wheel instead of front-right
    The robot veers left going forward because the FL servo drags. The old
    gain boosted FR, which steers further left. Max useful FL gain is ~1.15
    before the +-1 speed clamp; drop FR below 1.0 if more correction is
    needed.
    [buddy_pi.py]
2026-07-17 Lower default camera settings to 320x240 q50 for latency
2026-07-17 Counter the left drag with the back wheel instead of front gains
    Revert per-wheel gains to 1.0 and add BACK_ASSIST: the sideways back
    wheel runs at 0.15x while driving fwd/back to counter-steer the nose
    pulling left from the draggy FL servo. Tunable via --back-assist
    (negative flips direction, 0 disables).
    [buddy_pi.py]
2026-07-17 Support holding multiple drive keys at once (W+A/D steering)
    The browser now tracks all held directions and sends a combined
    {type: vec, vx, vy} message instead of one direction at a time, so
    holding W then tapping A/D corrects drift mid-drive. Opposite keys
    cancel; releasing everything still sends the old stop cmd. The Pi
    normalizes diagonals so no wheel clips at the speed clamp. Also stop
    all drive when the tab loses focus (keyup never arrives).
    [buddy_pi.py]
2026-07-17 Soften the controls: slower drive speed, gentler steer-while-driving
    DRIVE_US 100 -> 70 so everything moves slower overall, and the sideways
    component of a combined W+A/D command is halved (STEER_MIX) so drift
    corrections nudge the heading instead of yanking it. Pure A/D turning
    is unchanged.
    [buddy_pi.py]
2026-10-29 custom PCB
2026-10-29 pcb build
2026-10-29 ino update lag fixes, pcb routed
2026-11-02 final PCB design push
2026-11-02 final PCB design push, design notebook
